y11478230-wq/star-anise-fpga/camera_hdmi_720p_fpga_sixpanel_delivery/ip_repo/sixpanel_accel/hdl/vhdl/sixpanel_accel_control_s_axi.vhd

-- ==============================================================
-- Vitis HLS - High-Level Synthesis from C, C++ and OpenCL v2026.1 (64-bit)
-- Tool Version Limit: 2026.06
-- Copyright 1986-2022 Xilinx, Inc. All Rights Reserved.
-- Copyright 2022-2026 Advanced Micro Devices, Inc. All Rights Reserved.
-- 
-- ==============================================================
library IEEE;
use IEEE.STD_LOGIC_1164.all;
use IEEE.NUMERIC_STD.all;

entity sixpanel_accel_control_s_axi is
generic (
    C_S_AXI_ADDR_WIDTH    : INTEGER := 7;
    C_S_AXI_DATA_WIDTH    : INTEGER := 32);
port (
    ACLK                  :in   STD_LOGIC;
    ARESET                :in   STD_LOGIC;
    ACLK_EN               :in   STD_LOGIC;
    AWADDR                :in   STD_LOGIC_VECTOR(C_S_AXI_ADDR_WIDTH-1 downto 0);
    AWVALID               :in   STD_LOGIC;
    AWREADY               :out  STD_LOGIC;
    WDATA                 :in   STD_LOGIC_VECTOR(C_S_AXI_DATA_WIDTH-1 downto 0);
    WSTRB                 :in   STD_LOGIC_VECTOR(C_S_AXI_DATA_WIDTH/8-1 downto 0);
    WVALID                :in   STD_LOGIC;
    WREADY                :out  STD_LOGIC;
    BRESP                 :out  STD_LOGIC_VECTOR(1 downto 0);
    BVALID                :out  STD_LOGIC;
    BREADY                :in   STD_LOGIC;
    ARADDR                :in   STD_LOGIC_VECTOR(C_S_AXI_ADDR_WIDTH-1 downto 0);
    ARVALID               :in   STD_LOGIC;
    ARREADY               :out  STD_LOGIC;
    RDATA                 :out  STD_LOGIC_VECTOR(C_S_AXI_DATA_WIDTH-1 downto 0);
    RRESP                 :out  STD_LOGIC_VECTOR(1 downto 0);
    RVALID                :out  STD_LOGIC;
    RREADY                :in   STD_LOGIC;
    interrupt             :out  STD_LOGIC;
    camera_frame          :out  STD_LOGIC_VECTOR(63 downto 0);
    mosaic_frame          :out  STD_LOGIC_VECTOR(63 downto 0);
    fill_history          :out  STD_LOGIC_VECTOR(63 downto 0);
    panel_workspace       :out  STD_LOGIC_VECTOR(63 downto 0);
    clear_history         :out  STD_LOGIC_VECTOR(0 downto 0);
    ap_start              :out  STD_LOGIC;
    ap_done               :in   STD_LOGIC;
    ap_ready              :in   STD_LOGIC;
    ap_idle               :in   STD_LOGIC
);
end entity sixpanel_accel_control_s_axi;

-- ------------------------Address Info-------------------
-- Protocol Used: ap_ctrl_hs
--
-- 0x00 : Control signals
--        bit 0  - ap_start (Read/Write/COH)
--        bit 1  - ap_done (Read/COR)
--        bit 2  - ap_idle (Read)
--        bit 3  - ap_ready (Read/COR)
--        bit 7  - auto_restart (Read/Write)
--        bit 9  - interrupt (Read)
--        others - reserved
-- 0x04 : Global Interrupt Enable Register
--        bit 0  - Global Interrupt Enable (Read/Write)
--        others - reserved
-- 0x08 : IP Interrupt Enable Register (Read/Write)
--        bit 0 - enable ap_done interrupt (Read/Write)
--        bit 1 - enable ap_ready interrupt (Read/Write)
--        others - reserved
-- 0x0c : IP Interrupt Status Register (Read/TOW)
--        bit 0 - ap_done (Read/TOW)
--        bit 1 - ap_ready (Read/TOW)
--        others - reserved
-- 0x10 : Data signal of camera_frame
--        bit 31~0 - camera_frame[31:0] (Read/Write)
-- 0x14 : Data signal of camera_frame
--        bit 31~0 - camera_frame[63:32] (Read/Write)
-- 0x18 : reserved
-- 0x1c : Data signal of mosaic_frame
--        bit 31~0 - mosaic_frame[31:0] (Read/Write)
-- 0x20 : Data signal of mosaic_frame
--        bit 31~0 - mosaic_frame[63:32] (Read/Write)
-- 0x24 : reserved
-- 0x28 : Data signal of fill_history
--        bit 31~0 - fill_history[31:0] (Read/Write)
-- 0x2c : Data signal of fill_history
--        bit 31~0 - fill_history[63:32] (Read/Write)
-- 0x30 : reserved
-- 0x34 : Data signal of panel_workspace
--        bit 31~0 - panel_workspace[31:0] (Read/Write)
-- 0x38 : Data signal of panel_workspace
--        bit 31~0 - panel_workspace[63:32] (Read/Write)
-- 0x3c : reserved
-- 0x40 : Data signal of clear_history
--        bit 0  - clear_history[0] (Read/Write)
--        others - reserved
-- 0x44 : reserved
-- (SC = Self Clear, COR = Clear on Read, TOW = Toggle on Write, COH = Clear on Handshake)

architecture behave of sixpanel_accel_control_s_axi is
attribute DowngradeIPIdentifiedWarnings : STRING;
attribute DowngradeIPIdentifiedWarnings of behave : architecture is "yes";
    type states is (wridle, wrdata, wrresp, wrreset, rdidle, rddata, rdreset);  -- read and write fsm states
    signal wstate  : states := wrreset;
    signal rstate  : states := rdreset;
    signal wnext, rnext: states;
    constant ADDR_AP_CTRL                : INTEGER := 16#00#;
    constant ADDR_GIE                    : INTEGER := 16#04#;
    constant ADDR_IER                    : INTEGER := 16#08#;
    constant ADDR_ISR                    : INTEGER := 16#0c#;
    constant ADDR_CAMERA_FRAME_DATA_0    : INTEGER := 16#10#;
    constant ADDR_CAMERA_FRAME_DATA_1    : INTEGER := 16#14#;
    constant ADDR_CAMERA_FRAME_CTRL      : INTEGER := 16#18#;
    constant ADDR_MOSAIC_FRAME_DATA_0    : INTEGER := 16#1c#;
    constant ADDR_MOSAIC_FRAME_DATA_1    : INTEGER := 16#20#;
    constant ADDR_MOSAIC_FRAME_CTRL      : INTEGER := 16#24#;
    constant ADDR_FILL_HISTORY_DATA_0    : INTEGER := 16#28#;
    constant ADDR_FILL_HISTORY_DATA_1    : INTEGER := 16#2c#;
    constant ADDR_FILL_HISTORY_CTRL      : INTEGER := 16#30#;
    constant ADDR_PANEL_WORKSPACE_DATA_0 : INTEGER := 16#34#;
    constant ADDR_PANEL_WORKSPACE_DATA_1 : INTEGER := 16#38#;
    constant ADDR_PANEL_WORKSPACE_CTRL   : INTEGER := 16#3c#;
    constant ADDR_CLEAR_HISTORY_DATA_0   : INTEGER := 16#40#;
    constant ADDR_CLEAR_HISTORY_CTRL     : INTEGER := 16#44#;
    constant ADDR_BITS         : INTEGER := 7;

    signal AWREADY_t           : STD_LOGIC;
    signal WREADY_t            : STD_LOGIC;
    signal ARREADY_t           : STD_LOGIC;
    signal RVALID_t            : STD_LOGIC;
    signal BVALID_t            : STD_LOGIC;
    signal waddr               : UNSIGNED(ADDR_BITS-1 downto 0);
    signal wmask               : UNSIGNED(C_S_AXI_DATA_WIDTH-1 downto 0);
    signal aw_hs               : STD_LOGIC;
    signal w_hs                : STD_LOGIC;
    signal rdata_data          : UNSIGNED(C_S_AXI_DATA_WIDTH-1 downto 0);
    signal ar_hs               : STD_LOGIC;
    signal raddr               : UNSIGNED(ADDR_BITS-1 downto 0);
    -- internal registers
    signal int_ap_idle         : STD_LOGIC := '0';
    signal int_ap_ready        : STD_LOGIC := '0';
    signal task_ap_ready       : STD_LOGIC;
    signal int_ap_done         : STD_LOGIC := '0';
    signal task_ap_done        : STD_LOGIC;
    signal int_task_ap_done    : STD_LOGIC := '0';
    signal int_ap_start        : STD_LOGIC := '0';
    signal int_interrupt       : STD_LOGIC := '0';
    signal int_auto_restart    : STD_LOGIC := '0';
    signal auto_restart_status : STD_LOGIC := '0';
    signal auto_restart_done   : STD_LOGIC;
    signal int_gie             : STD_LOGIC := '0';
    signal int_ier             : UNSIGNED(1 downto 0) := (others => '0');
    signal int_isr             : UNSIGNED(1 downto 0) := (others => '0');
    signal int_camera_frame    : UNSIGNED(63 downto 0) := (others => '0');
    signal int_mosaic_frame    : UNSIGNED(63 downto 0) := (others => '0');
    signal int_fill_history    : UNSIGNED(63 downto 0) := (others => '0');
    signal int_panel_workspace : UNSIGNED(63 downto 0) := (others => '0');
    signal int_clear_history   : UNSIGNED(0 downto 0) := (others => '0');


begin
-- ----------------------- Instantiation------------------


-- ----------------------- AXI WRITE ---------------------
    AWREADY_t <=  '1' when wstate = wridle else '0';
    AWREADY   <=  AWREADY_t;
    WREADY_t  <=  '1' when wstate = wrdata else '0';
    WREADY    <=  WREADY_t;
    BVALID_t  <=  '1' when wstate = wrresp else '0';
    BVALID    <=  BVALID_t;
    BRESP     <=  "00";  -- OKAY
    wmask     <=  (31 downto 24 => WSTRB(3), 23 downto 16 => WSTRB(2), 15 downto 8 => WSTRB(1), 7 downto 0 => WSTRB(0));
    aw_hs     <=  AWVALID and AWREADY_t;
    w_hs      <=  WVALID and WREADY_t;

    -- write FSM
    process (ACLK)
    begin
        if (ACLK'event and ACLK = '1') then
            if (ARESET = '1') then
                wstate <= wrreset;
            elsif (ACLK_EN = '1') then
                wstate <= wnext;
            end if;
        end if;
    end process;

    process (wstate, AWVALID, WVALID, BREADY, BVALID_t)
    begin
        case (wstate) is
        when wridle =>
            if (AWVALID = '1') then
                wnext <= wrdata;
            else
                wnext <= wridle;
            end if;
        when wrdata =>
            if (WVALID = '1') then
                wnext <= wrresp;
            else
                wnext <= wrdata;
            end if;
        when wrresp =>
            if (BREADY = '1' and BVALID_t = '1') then
                wnext <= wridle;
            else
                wnext <= wrresp;
            end if;
        when others =>
            wnext <= wridle;
        end case;
    end process;

    waddr_proc : process (ACLK)
    begin
        if (ACLK'event and ACLK = '1') then
            if (ACLK_EN = '1') then
                if (aw_hs = '1') then
                    waddr <= UNSIGNED(AWADDR(ADDR_BITS-1 downto 2) & (1 downto 0 => '0'));
                end if;
            end if;
        end if;
    end process;

-- ----------------------- AXI READ ----------------------
    ARREADY_t <= '1' when (rstate = rdidle) else '0';
    ARREADY <= ARREADY_t;
    RDATA   <= STD_LOGIC_VECTOR(rdata_data);
    RRESP   <= "00";  -- OKAY
    RVALID_t  <= '1' when (rstate = rddata) else '0';
    RVALID    <= RVALID_t;
    ar_hs   <= ARVALID and ARREADY_t;
    raddr   <= UNSIGNED(ARADDR(ADDR_BITS-1 downto 0));

    -- read FSM
    process (ACLK)
    begin
        if (ACLK'event and ACLK = '1') then
            if (ARESET = '1') then
                rstate <= rdreset;
            elsif (ACLK_EN = '1') then
                rstate <= rnext;
            end if;
        end if;
    end process;

    process (rstate, ARVALID, RREADY, RVALID_t)
    begin
        case (rstate) is
        when rdidle =>
            if (ARVALID = '1') then
                rnext <= rddata;
            else
                rnext <= rdidle;
            end if;
        when rddata =>
            if (RREADY = '1' and RVALID_t = '1') then
                rnext <= rdidle;
            else
                rnext <= rddata;
            end if;
        when others =>
            rnext <= rdidle;
        end case;
    end process;

    rdata_proc : process (ACLK)
    begin
        if (ACLK'event and ACLK = '1') then
            if (ACLK_EN = '1') then
                if (ar_hs = '1') then
                    rdata_data <= (others => '0');
                    case (TO_INTEGER(raddr)) is
                    when ADDR_AP_CTRL =>
                        rdata_data(9) <= int_interrupt;
                        rdata_data(7) <= int_auto_restart;
                        rdata_data(3) <= int_ap_ready;
                        rdata_data(2) <= int_ap_idle;
                        rdata_data(1) <= int_task_ap_done;
                        rdata_data(0) <= int_ap_start;
                    when ADDR_GIE =>
                        rdata_data(0) <= int_gie;
                    when ADDR_IER =>
                        rdata_data(1 downto 0) <= int_ier;
                    when ADDR_ISR =>
                        rdata_data(1 downto 0) <= int_isr;
                    when ADDR_CAMERA_FRAME_DATA_0 =>
                        rdata_data <= RESIZE(int_camera_frame(31 downto 0), 32);
                    when ADDR_CAMERA_FRAME_DATA_1 =>
                        rdata_data <= RESIZE(int_camera_frame(63 downto 32), 32);
                    when ADDR_MOSAIC_FRAME_DATA_0 =>
                        rdata_data <= RESIZE(int_mosaic_frame(31 downto 0), 32);
                    when ADDR_MOSAIC_FRAME_DATA_1 =>
                        rdata_data <= RESIZE(int_mosaic_frame(63 downto 32), 32);
                    when ADDR_FILL_HISTORY_DATA_0 =>
                        rdata_data <= RESIZE(int_fill_history(31 downto 0), 32);
                    when ADDR_FILL_HISTORY_DATA_1 =>
                        rdata_data <= RESIZE(int_fill_history(63 downto 32), 32);
                    when ADDR_PANEL_WORKSPACE_DATA_0 =>
                        rdata_data <= RESIZE(int_panel_workspace(31 downto 0), 32);
                    when ADDR_PANEL_WORKSPACE_DATA_1 =>
                        rdata_data <= RESIZE(int_panel_workspace(63 downto 32), 32);
                    when ADDR_CLEAR_HISTORY_DATA_0 =>
                        rdata_data <= RESIZE(int_clear_history(0 downto 0), 32);
                    when others =>
                        NULL;
                    end case;
                end if;
            end if;
        end if;
    end process;

-- ----------------------- Register logic ----------------
    interrupt            <= int_interrupt;
    ap_start             <= int_ap_start;
    task_ap_done         <= (ap_done and not auto_restart_status) or auto_restart_done;
    task_ap_ready        <= ap_ready and not int_auto_restart;
    auto_restart_done    <= auto_restart_status and (ap_idle and not int_ap_idle);
    camera_frame         <= STD_LOGIC_VECTOR(int_camera_frame);
    mosaic_frame         <= STD_LOGIC_VECTOR(int_mosaic_frame);
    fill_history         <= STD_LOGIC_VECTOR(int_fill_history);
    panel_workspace      <= STD_LOGIC_VECTOR(int_panel_workspace);
    clear_history        <= STD_LOGIC_VECTOR(int_clear_history);

    process (ACLK)
    begin
        if (ACLK'event and ACLK = '1') then
            if (ARESET = '1') then
                int_interrupt <= '0';
            elsif (ACLK_EN = '1') then
                if (int_gie = '1' and (int_isr(0) or int_isr(1)) = '1') then
                    int_interrupt <= '1';
                else
                    int_interrupt <= '0';
                end if;
            end if;
        end if;
    end process;

    process (ACLK)
    begin
        if (ACLK'event and ACLK = '1') then
            if (ARESET = '1') then
                int_ap_start <= '0';
            elsif (ACLK_EN = '1') then
                if (w_hs = '1' and waddr = ADDR_AP_CTRL and WSTRB(0) = '1' and WDATA(0) = '1') then
                    int_ap_start <= '1';
                elsif (ap_ready = '1') then
                    int_ap_start <= int_auto_restart; -- clear on handshake/auto restart
                end if;
            end if;
        end if;
    end process;

    process (ACLK)
    begin
        if (ACLK'event and ACLK = '1') then
            if (ARESET = '1') then
                int_ap_done <= '0';
            elsif (ACLK_EN = '1') then
                if (true) then
                    int_ap_done <= ap_done;
                end if;
            end if;
        end if;
    end process;

    process (ACLK)
    begin
        if (ACLK'event and ACLK = '1') then
            if (ARESET = '1') then
                int_task_ap_done <= '0';
            elsif (ACLK_EN = '1') then
                if (task_ap_done = '1') then
                    int_task_ap_done <= '1';
                elsif (ar_hs = '1' and raddr = ADDR_AP_CTRL) then
                    int_task_ap_done <= '0'; -- clear on read
                end if;
            end if;
        end if;
    end process;

    process (ACLK)
    begin
        if (ACLK'event and ACLK = '1') then
            if (ARESET = '1') then
                int_ap_idle <= '0';
            elsif (ACLK_EN = '1') then
                if (true) then
                    int_ap_idle <= ap_idle;
                end if;
            end if;
        end if;
    end process;

    process (ACLK)
    begin
        if (ACLK'event and ACLK = '1') then
            if (ARESET = '1') then
                int_ap_ready <= '0';
            elsif (ACLK_EN = '1') then
                if (task_ap_ready = '1') then
                    int_ap_ready <= '1';
                elsif (ar_hs = '1' and raddr = ADDR_AP_CTRL) then
                    int_ap_ready <= '0';
                end if;
            end if;
        end if;
    end process;

    process (ACLK)
    begin
        if (ACLK'event and ACLK = '1') then
            if (ARESET = '1') then
                int_auto_restart <= '0';
            elsif (ACLK_EN = '1') then
                if (w_hs = '1' and waddr = ADDR_AP_CTRL and WSTRB(0) = '1') then
                    int_auto_restart <= WDATA(7);
                end if;
            end if;
        end if;
    end process;

    process (ACLK)
    begin
        if (ACLK'event and ACLK = '1') then
            if (ARESET = '1') then
                auto_restart_status <= '0';
            elsif (ACLK_EN = '1') then
                if (int_auto_restart = '1') then
                    auto_restart_status <= '1';
                elsif (ap_idle = '1') then
                    auto_restart_status <= '0';
                end if;
            end if;
        end if;
    end process;

    process (ACLK)
    begin
        if (ACLK'event and ACLK = '1') then
            if (ARESET = '1') then
                int_gie <= '0';
            elsif (ACLK_EN = '1') then
                if (w_hs = '1' and waddr = ADDR_GIE and WSTRB(0) = '1') then
                    int_gie <= WDATA(0);
                end if;
            end if;
        end if;
    end process;

    process (ACLK)
    begin
        if (ACLK'event and ACLK = '1') then
            if (ARESET = '1') then
                int_ier <= (others=>'0');
            elsif (ACLK_EN = '1') then
                if (w_hs = '1' and waddr = ADDR_IER and WSTRB(0) = '1') then
                    int_ier <= UNSIGNED(WDATA(1 downto 0));
                end if;
            end if;
        end if;
    end process;

    process (ACLK)
    begin
        if (ACLK'event and ACLK = '1') then
            if (ARESET = '1') then
                int_isr(0) <= '0';
            elsif (ACLK_EN = '1') then
                if (int_ier(0) = '1' and ap_done = '1') then
                    int_isr(0) <= '1';
                elsif (w_hs = '1' and waddr = ADDR_ISR and WSTRB(0) = '1') then
                    int_isr(0) <= int_isr(0) xor WDATA(0); -- toggle on write
                end if;
            end if;
        end if;
    end process;

    process (ACLK)
    begin
        if (ACLK'event and ACLK = '1') then
            if (ARESET = '1') then
                int_isr(1) <= '0';
            elsif (ACLK_EN = '1') then
                if (int_ier(1) = '1' and ap_ready = '1') then
                    int_isr(1) <= '1';
                elsif (w_hs = '1' and waddr = ADDR_ISR and WSTRB(0) = '1') then
                    int_isr(1) <= int_isr(1) xor WDATA(1); -- toggle on write
                end if;
            end if;
        end if;
    end process;

    process (ACLK)
    begin
        if (ACLK'event and ACLK = '1') then
            if (ARESET = '1') then
                int_camera_frame(31 downto 0) <= (others => '0');
            elsif (ACLK_EN = '1') then
                if (w_hs = '1' and waddr = ADDR_CAMERA_FRAME_DATA_0) then
                    int_camera_frame(31 downto 0) <= (UNSIGNED(WDATA(31 downto 0)) and wmask(31 downto 0)) or ((not wmask(31 downto 0)) and int_camera_frame(31 downto 0));
                end if;
            end if;
        end if;
    end process;

    process (ACLK)
    begin
        if (ACLK'event and ACLK = '1') then
            if (ARESET = '1') then
                int_camera_frame(63 downto 32) <= (others => '0');
            elsif (ACLK_EN = '1') then
                if (w_hs = '1' and waddr = ADDR_CAMERA_FRAME_DATA_1) then
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
                end if;
            end if;
        end if;
    end process;


-- ----------------------- Memory logic ------------------

end architecture behave;
