y11478230-wq/star-anise-fpga/camera_hdmi_720p_fpga_sixpanel_delivery/ip_repo/sixpanel_accel/drivers/sixpanel_accel_v1_0/src/xsixpanel_accel.h

// ==============================================================
// Vitis HLS - High-Level Synthesis from C, C++ and OpenCL v2026.1 (64-bit)
// Tool Version Limit: 2026.06
// Copyright 1986-2022 Xilinx, Inc. All Rights Reserved.
// Copyright 2022-2026 Advanced Micro Devices, Inc. All Rights Reserved.
// 
// ==============================================================
#ifndef XSIXPANEL_ACCEL_H
#define XSIXPANEL_ACCEL_H

#ifdef __cplusplus
extern "C" {
#endif

/***************************** Include Files *********************************/
#ifndef __linux__
#include "xil_types.h"
#include "xil_assert.h"
#include "xstatus.h"
#include "xil_io.h"
#else
#include <stdint.h>
#include <assert.h>
#include <dirent.h>
#include <fcntl.h>
#include <stdio.h>
#include <stdlib.h>
#include <string.h>
#include <sys/mman.h>
#include <unistd.h>
#include <stddef.h>
#endif
#include "xsixpanel_accel_hw.h"

/**************************** Type Definitions ******************************/
#ifdef __linux__
typedef uint8_t u8;
typedef uint16_t u16;
typedef uint32_t u32;
typedef uint64_t u64;
#else
typedef struct {
#ifdef SDT
    char *Name;
#else
    u16 DeviceId;
#endif
    u64 Control_BaseAddress;
} XSixpanel_accel_Config;
#endif

typedef struct {
    u64 Control_BaseAddress;
    u32 IsReady;
} XSixpanel_accel;

typedef u32 word_type;

/***************** Macros (Inline Functions) Definitions *********************/
#ifndef __linux__
#define XSixpanel_accel_WriteReg(BaseAddress, RegOffset, Data) \
    Xil_Out32((BaseAddress) + (RegOffset), (u32)(Data))
#define XSixpanel_accel_ReadReg(BaseAddress, RegOffset) \
    Xil_In32((BaseAddress) + (RegOffset))
#else
#define XSixpanel_accel_WriteReg(BaseAddress, RegOffset, Data) \
    *(volatile u32*)((BaseAddress) + (RegOffset)) = (u32)(Data)
#define XSixpanel_accel_ReadReg(BaseAddress, RegOffset) \
    *(volatile u32*)((BaseAddress) + (RegOffset))

#define Xil_AssertVoid(expr)    assert(expr)
#define Xil_AssertNonvoid(expr) assert(expr)

#define XST_SUCCESS             0
#define XST_DEVICE_NOT_FOUND    2
#define XST_OPEN_DEVICE_FAILED  3
#define XIL_COMPONENT_IS_READY  1
#endif

/************************** Function Prototypes *****************************/
#ifndef __linux__
#ifdef SDT
int XSixpanel_accel_Initialize(XSixpanel_accel *InstancePtr, UINTPTR BaseAddress);
XSixpanel_accel_Config* XSixpanel_accel_LookupConfig(UINTPTR BaseAddress);
#else
int XSixpanel_accel_Initialize(XSixpanel_accel *InstancePtr, u16 DeviceId);
XSixpanel_accel_Config* XSixpanel_accel_LookupConfig(u16 DeviceId);
#endif
int XSixpanel_accel_CfgInitialize(XSixpanel_accel *InstancePtr, XSixpanel_accel_Config *ConfigPtr);
#else
int XSixpanel_accel_Initialize(XSixpanel_accel *InstancePtr, const char* InstanceName);
int XSixpanel_accel_Release(XSixpanel_accel *InstancePtr);
#endif

void XSixpanel_accel_Start(XSixpanel_accel *InstancePtr);
u32 XSixpanel_accel_IsDone(XSixpanel_accel *InstancePtr);
u32 XSixpanel_accel_IsIdle(XSixpanel_accel *InstancePtr);
u32 XSixpanel_accel_IsReady(XSixpanel_accel *InstancePtr);
void XSixpanel_accel_EnableAutoRestart(XSixpanel_accel *InstancePtr);
void XSixpanel_accel_DisableAutoRestart(XSixpanel_accel *InstancePtr);

void XSixpanel_accel_Set_camera_frame(XSixpanel_accel *InstancePtr, u64 Data);
u64 XSixpanel_accel_Get_camera_frame(XSixpanel_accel *InstancePtr);
void XSixpanel_accel_Set_mosaic_frame(XSixpanel_accel *InstancePtr, u64 Data);
u64 XSixpanel_accel_Get_mosaic_frame(XSixpanel_accel *InstancePtr);
void XSixpanel_accel_Set_fill_history(XSixpanel_accel *InstancePtr, u64 Data);
u64 XSixpanel_accel_Get_fill_history(XSixpanel_accel *InstancePtr);
void XSixpanel_accel_Set_panel_workspace(XSixpanel_accel *InstancePtr, u64 Data);
u64 XSixpanel_accel_Get_panel_workspace(XSixpanel_accel *InstancePtr);
void XSixpanel_accel_Set_clear_history(XSixpanel_accel *InstancePtr, u32 Data);
u32 XSixpanel_accel_Get_clear_history(XSixpanel_accel *InstancePtr);

void XSixpanel_accel_InterruptGlobalEnable(XSixpanel_accel *InstancePtr);
void XSixpanel_accel_InterruptGlobalDisable(XSixpanel_accel *InstancePtr);
void XSixpanel_accel_InterruptEnable(XSixpanel_accel *InstancePtr, u32 Mask);
void XSixpanel_accel_InterruptDisable(XSixpanel_accel *InstancePtr, u32 Mask);
void XSixpanel_accel_InterruptClear(XSixpanel_accel *InstancePtr, u32 Mask);
u32 XSixpanel_accel_InterruptGetEnabled(XSixpanel_accel *InstancePtr);
u32 XSixpanel_accel_InterruptGetStatus(XSixpanel_accel *InstancePtr);

#ifdef __cplusplus
}
#endif

#endif
