y11478230-wq/star-anise-fpga/camera_hdmi_720p_fpga_sixpanel_delivery/ip_repo/sixpanel_accel/drivers/sixpanel_accel_v1_0/src/xsixpanel_accel_sinit.c

// ==============================================================
// Vitis HLS - High-Level Synthesis from C, C++ and OpenCL v2026.1 (64-bit)
// Tool Version Limit: 2026.06
// Copyright 1986-2022 Xilinx, Inc. All Rights Reserved.
// Copyright 2022-2026 Advanced Micro Devices, Inc. All Rights Reserved.
// 
// ==============================================================
#ifndef __linux__

#include "xstatus.h"
#ifdef SDT
#include "xparameters.h"
#endif
#include "xsixpanel_accel.h"

extern XSixpanel_accel_Config XSixpanel_accel_ConfigTable[];

#ifdef SDT
XSixpanel_accel_Config *XSixpanel_accel_LookupConfig(UINTPTR BaseAddress) {
	XSixpanel_accel_Config *ConfigPtr = NULL;

	int Index;

	for (Index = (u32)0x0; XSixpanel_accel_ConfigTable[Index].Name != NULL; Index++) {
		if (!BaseAddress || XSixpanel_accel_ConfigTable[Index].Control_BaseAddress == BaseAddress) {
			ConfigPtr = &XSixpanel_accel_ConfigTable[Index];
			break;
		}
	}

	return ConfigPtr;
}

int XSixpanel_accel_Initialize(XSixpanel_accel *InstancePtr, UINTPTR BaseAddress) {
	XSixpanel_accel_Config *ConfigPtr;

	Xil_AssertNonvoid(InstancePtr != NULL);

	ConfigPtr = XSixpanel_accel_LookupConfig(BaseAddress);
	if (ConfigPtr == NULL) {
		InstancePtr->IsReady = 0;
		return (XST_DEVICE_NOT_FOUND);
	}

	return XSixpanel_accel_CfgInitialize(InstancePtr, ConfigPtr);
}
#else
XSixpanel_accel_Config *XSixpanel_accel_LookupConfig(u16 DeviceId) {
	XSixpanel_accel_Config *ConfigPtr = NULL;

	int Index;

	for (Index = 0; Index < XPAR_XSIXPANEL_ACCEL_NUM_INSTANCES; Index++) {
		if (XSixpanel_accel_ConfigTable[Index].DeviceId == DeviceId) {
			ConfigPtr = &XSixpanel_accel_ConfigTable[Index];
			break;
		}
	}

	return ConfigPtr;
}

int XSixpanel_accel_Initialize(XSixpanel_accel *InstancePtr, u16 DeviceId) {
	XSixpanel_accel_Config *ConfigPtr;

	Xil_AssertNonvoid(InstancePtr != NULL);

	ConfigPtr = XSixpanel_accel_LookupConfig(DeviceId);
	if (ConfigPtr == NULL) {
		InstancePtr->IsReady = 0;
		return (XST_DEVICE_NOT_FOUND);
	}

	return XSixpanel_accel_CfgInitialize(InstancePtr, ConfigPtr);
}
#endif

#endif
